CapnBry/flowknow/README.md

flowknow
========

ATmega-based flow meter and tally

Project directory structure
```
arduino/ - FlowKnow source code
eagle/   - Schematic and board design
```
