CapnBry/flowknow/eagle/flowknow-brd.png

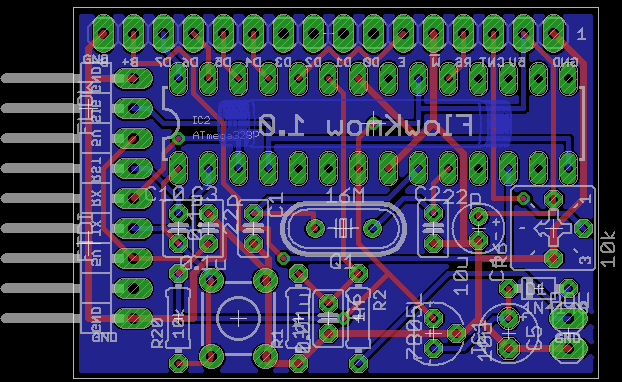
eagle/flowknow-brd.png
