CapnBry/flowknow/eagle/flowknow.png

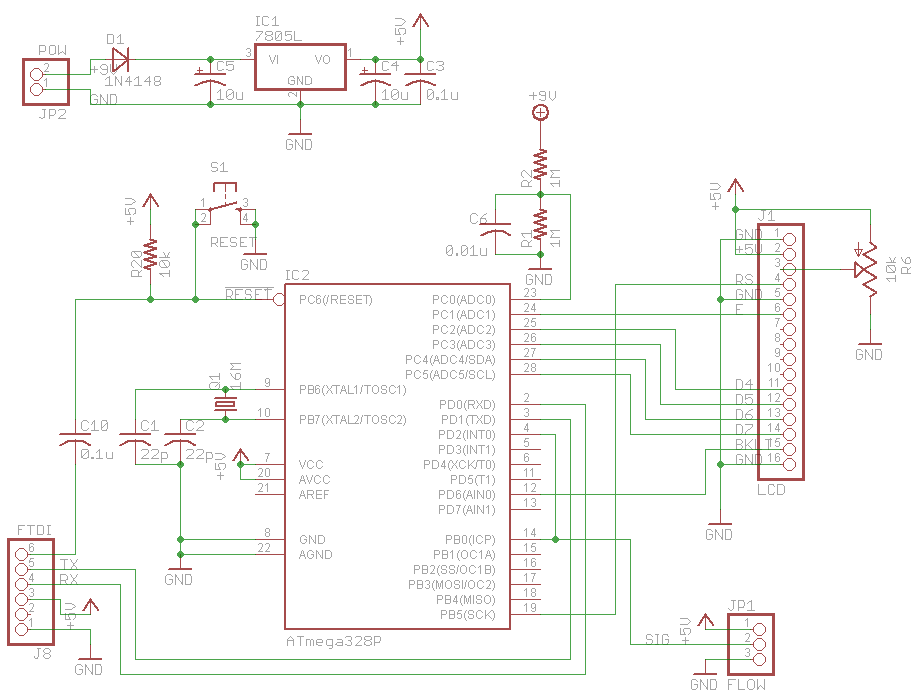
eagle/flowknow.png
