CapnBry/flowknow/eagle/FlowKnow.brd

## EAGLE design eagle/FlowKnow.brd (2015-08-12)

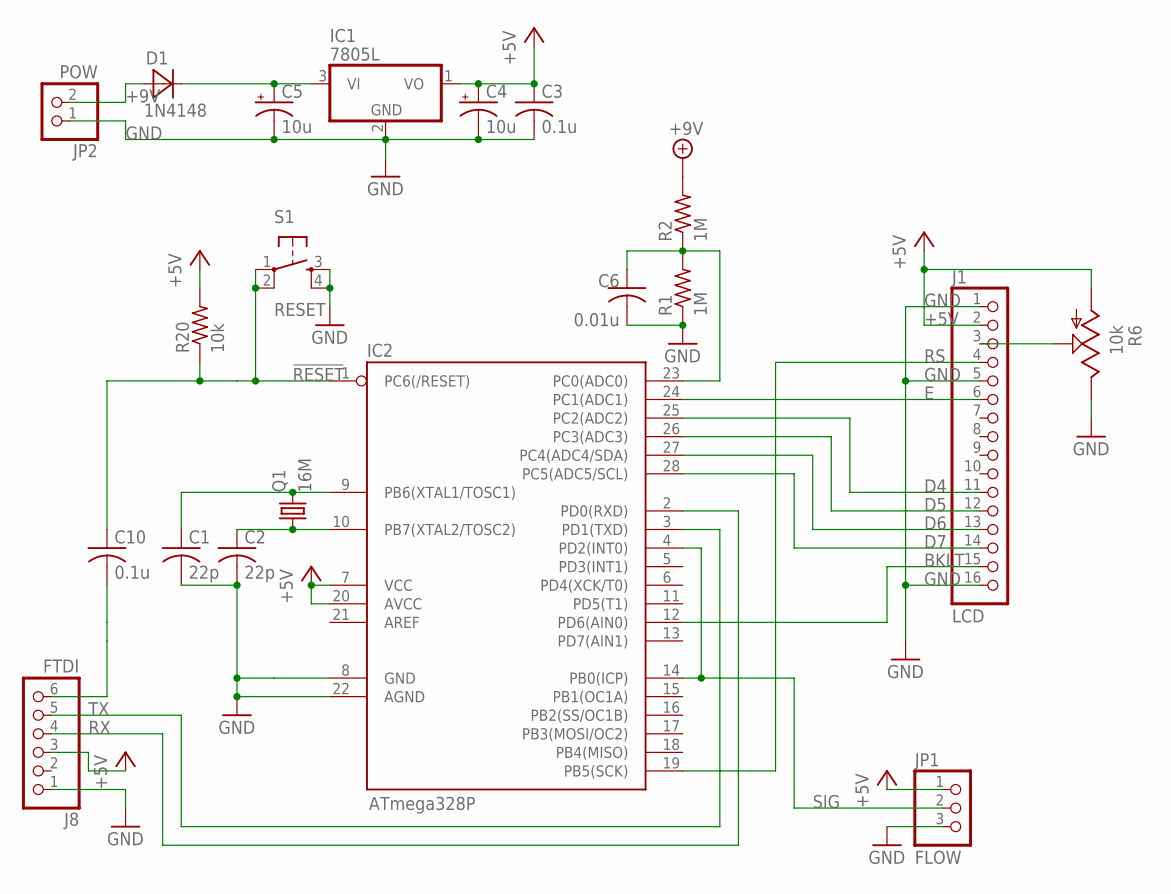
[picture p3: schematic FlowKnow.sch]

Parts:
C1, C2: 22p; C025-025X050
C3, C10: 0.1u; C025-025X050
C4: 10u; E2-4
C5: 10u; E2,5-5
C6: 0.01u; C025-025X050
D1: 1N4148; DO35-5
IC1: 7805L; TO92
IC2: ATmega328P; DIL28-3
J1: LCD; 1X16
J8: FTDI; 1X06/90
JP1: FLOW; 1X03/90
JP2: POW; 1X02
Q1: 16M; HC49/S
R1, R2: 1M; 0204/7
R6: 10k; CT6
R20: 10k; 0204/7
S1: RESET; TACTILE-PTH

Connections:
!RESET: C10.1, IC2.1 (PC6(/RESET)), R20.1, S1.1, S1.2
+5V: C3.1, C4.+, IC1.1 (VO), IC2.7 (VCC), IC2.20 (AVCC), J1.2, J8.3, JP1.1, R6.A, R20.2
+9V: D1.A, JP2.2, R2.2
BKLT: IC2.12 (PD6(AIN0)), J1.15
D4: IC2.25 (PC2(ADC2)), J1.11
D5: IC2.26 (PC3(ADC3)), J1.12
D6: IC2.27 (PC4(ADC4/SDA)), J1.13
D7: IC2.28 (PC5(ADC5/SCL)), J1.14
E: IC2.24 (PC1(ADC1)), J1.6
GND: C1.2, C2.2, C3.2, C4.-, C5.-, C6.2, IC1.2 (GND), IC2.8 (GND), IC2.22 (AGND), J1.1, J1.5, J1.16, J8.1, JP1.3, JP2.1, R1.1, R6.E, S1.3, S1.4
unnamed: C2.1, IC2.10 (PB7(XTAL2/TOSC2)), Q1.1
unnamed: C10.2, J8.6
unnamed: C1.1, IC2.9 (PB6(XTAL1/TOSC1)), Q1.2
unnamed: J1.3, R6.S
unnamed: C5.+, D1.C, IC1.3 (VI)
unnamed: C6.1, IC2.23 (PC0(ADC0)), R1.2, R2.1
RS: IC2.19 (PB5(SCK)), J1.4
RX: IC2.2 (PD0(RXD)), J8.4
SIG: IC2.4 (PD2(INT0)), IC2.14 (PB0(ICP)), JP1.2
TX: IC2.3 (PD1(TXD)), J8.5

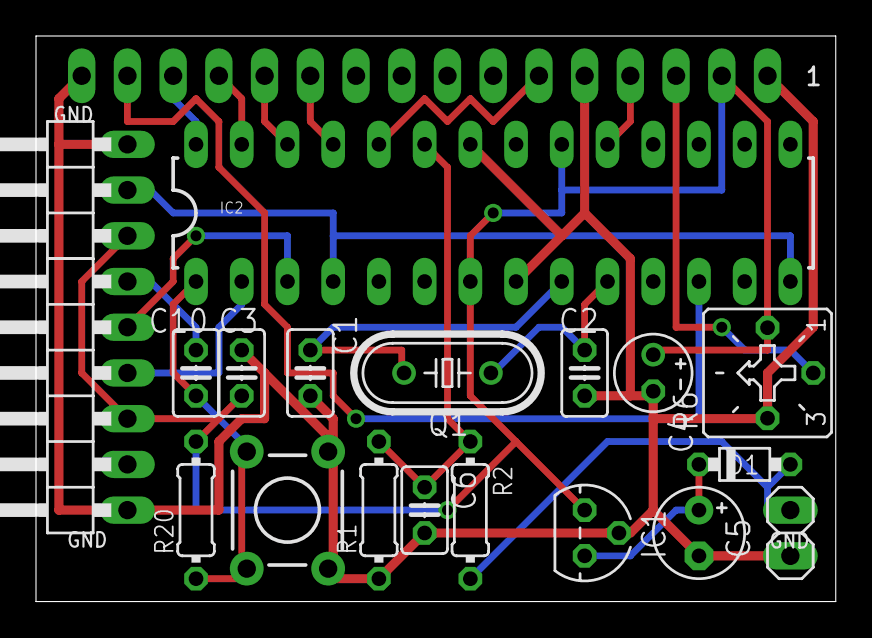
[picture p4: board FlowKnow.brd from above]

Board: 2 copper layers, 44.4 x 31.4 mm, 20 parts (1 on the bottom side), 20 nets.
