CapnBry/flowknow/(commit log)

2013-10-21 [pcb] Unrouted PCB import
    [FlowKnow.brd, FlowKnow.sch]
2014-01-24 [avr] Decouple the sensor reading from the LCD update to get more stable readings
    Old: Sensor read/LCD update 500ms, Animation 250ms
    New: Sensor read 1000ms, LCD update 666ms, Animation 333ms
    At 1 LPM that is only 2.5 ticks per the old 500ms update, it would either
    be 2 or 3 which is a 50% difference. Now it will get 4 5 or 6, which is
    only a 20% difference. The LCD will smooth between the updates
2014-01-24 [avr] Sleep with BOD enabled now
    There's no point in disabling the BOD when sleeping because the timers need
    to run so there's no going below IDLE.
2014-01-27 [avr] Fix overflow in timer count causing super-high lpm
    sleep() now always sleeps in exact multiples of LOOP_PERIOD
    Also move animation undate into the only place g_Liters changes, and time
    count to only where it changes
    [flowknow.ino]
2014-01-27 [avr] Update the sensor on the first loop
2014-01-27 [avr] Avoid potential buffer overflow in FloatPrint
    [floatprint.h]
2014-01-28 [avr] Variable sensor loop timing and coarse/fine smoothing. Requires 8MHz!
    -- Must be compiled with F_CPU 8Mhz now because sensor period can go over
    1s and will overflow TIMER1 counter. Will scale 16MHz CPU to 8MHz or
    DIV8 fused CPUs up to 8MHz.
    -- Sensor loop now scales between LOOPCNT_SENSOR_LO and LOOPCNT_SENSOR_HI
    depending on trigger count. Tries to prevent large variance caused by
    low frequency bouncing back and forth between e.g. 4-5Hz by extending
    the timeout
    -- Use a coarse exp moving avg when value is changing by more than 10%
    and a fine exp movign avg when value when mostly settled in
    -- Show FixedScale on LCD if set
    -- Adjusts default scaling to 2 decimals base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
    [flowknow.ino]
2014-01-29 [avr] Add 0.5 LPM calibration
2015-02-24 [avr] Constrain FloatPrint prints to width so it doesn't spill over.
    [floatprint.h]
2015-02-24 [avr] Update to Arduino 1.6.0
2015-08-12 [pcb] Update to use contrast pot instead of software (untested)
    [FlowKnow.brd, FlowKnow.sch]
2015-08-12 [avr] Fix powerdown taking LOOPCNT_LCD times too long
    [flowknow.ino]
